putyn/nixie-clock/resources/in4_manual.jpg

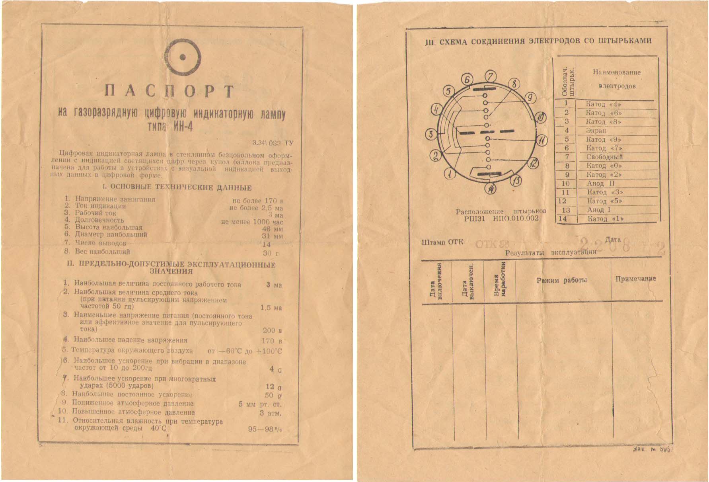
resources/in4_manual.jpg
