putyn/nixie-clock/README.md

naked nixie
=========

IN4 nixie tube + ESP8266
