putyn/nixie-clock/nixie-tubes/README.md

IN4 nixie tube PCB
------

1. in4_single_v0.1
	first version wth single nixie and power supply on the same board, idea was to test the power supplay and the driving circuit for nixies. Never made
2. in4_single_v0.2_revA
	second version which was manufactured at OSHPark, single nixie design made to be daisy chained
3. in4_single_v0.2_revB
	some improvements to version 0.2 (added another GND connection, some warning signs, change anode current limiting resistor to SMD, changed footprint for '595, reorderd schematic)
