putyn/nixie-clock/case/nixie_case_2_back_iso.png

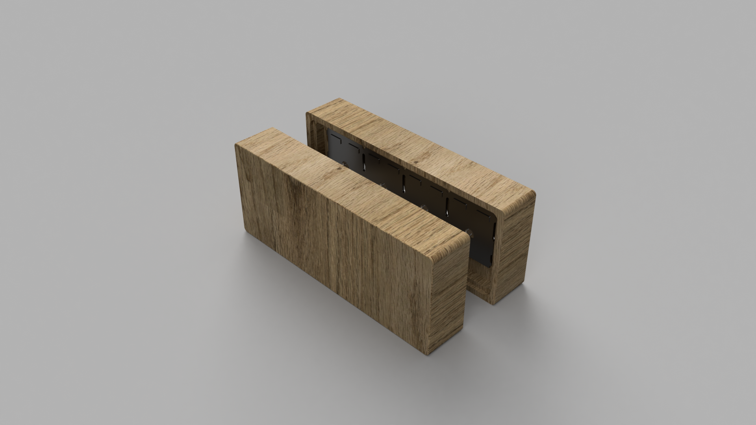
case/nixie_case_2_back_iso.png
