putyn/nixie-clock/case/nixie_case_2_front_iso.png

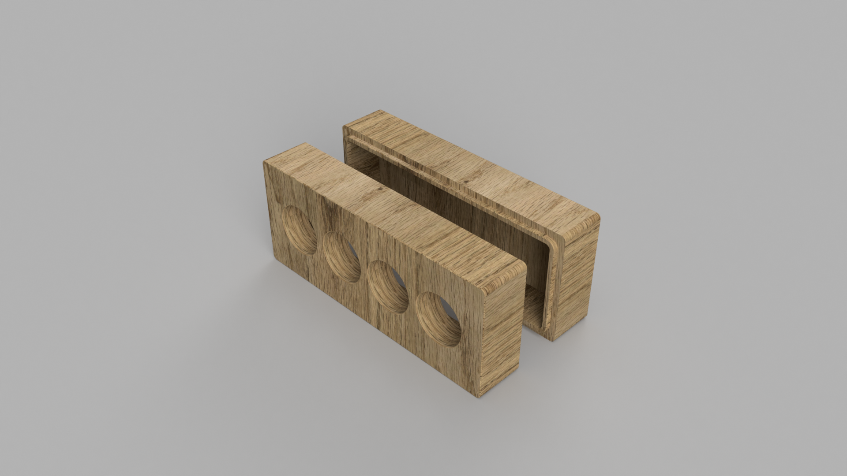
case/nixie_case_2_front_iso.png
