putyn/nixie-clock/case/in4_single_cutout.dxf

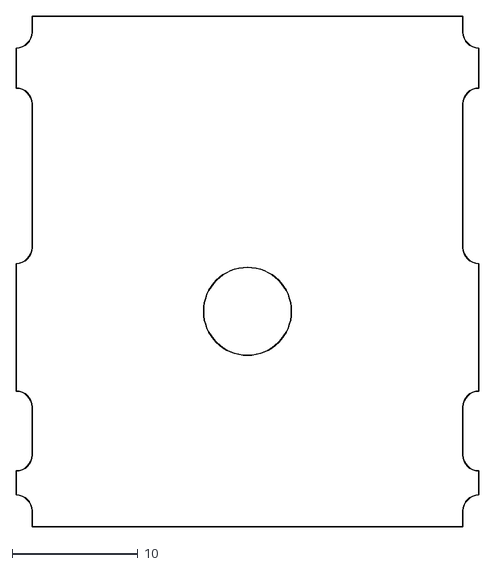
[picture p4: CAD file, 2017-02-05]
case/in4_single_cutout.dxf
36.8 x 40.6
