putyn/nixie-clock/(threads)

Thread 1 (2019-05-06):

Gerber File?

andreacampanella, 2019-05-06:
Would be nice to have gerber files for the PCBs as well :)

fabi280, 2019-05-14:
[in4_control_v1.0_revA_2019-05-06.zip](https://github.com/putyn/nixie-clock/files/3177637/in4_control_v1.0_revA_2019-05-06.zip)
[in4_single_v0.2_revB_2019-05-06.zip](https://github.com/putyn/nixie-clock/files/3177638/in4_single_v0.2_revB_2019-05-06.zip)
[in4_single_v0.2_revA_2019-05-14.zip](https://github.com/putyn/nixie-clock/files/3177644/in4_single_v0.2_revA_2019-05-14.zip)
[boosst_new_2019-05-14.zip](https://github.com/putyn/nixie-clock/files/3177650/boosst_new_2019-05-14.zip)
[boosst_revA_2019-05-14.zip](https://github.com/putyn/nixie-clock/files/3177651/boosst_revA_2019-05-14.zip)
[boosst_revB_2019-05-14.zip](https://github.com/putyn/nixie-clock/files/3177652/boosst_revB_2019-05-14.zip)

Closed 2021-03-08.

Thread 2 (2019-05-06):

BOM

xk4l23, 2019-05-06:
Hi, this is really a great project, would like to build one for me, too. Is there any change to get the BOM to the schematic? Or did I miss it? If so, please point me to the right place.

fabi280, 2019-05-11:
Yeah, you're right. Although you can even create a BOM there aren't any values specified

xk4l23, 2019-05-11:
That is what I am asking about. The values for the parts.

putyn, 2021-03-08:
looks like I'm a lousy repo owner, I don't have notifications turned on. @xk4l23 are you still interested in the BOM?
