putyn/nixie-clock/resources/Nixie Clock Rev C.PDF

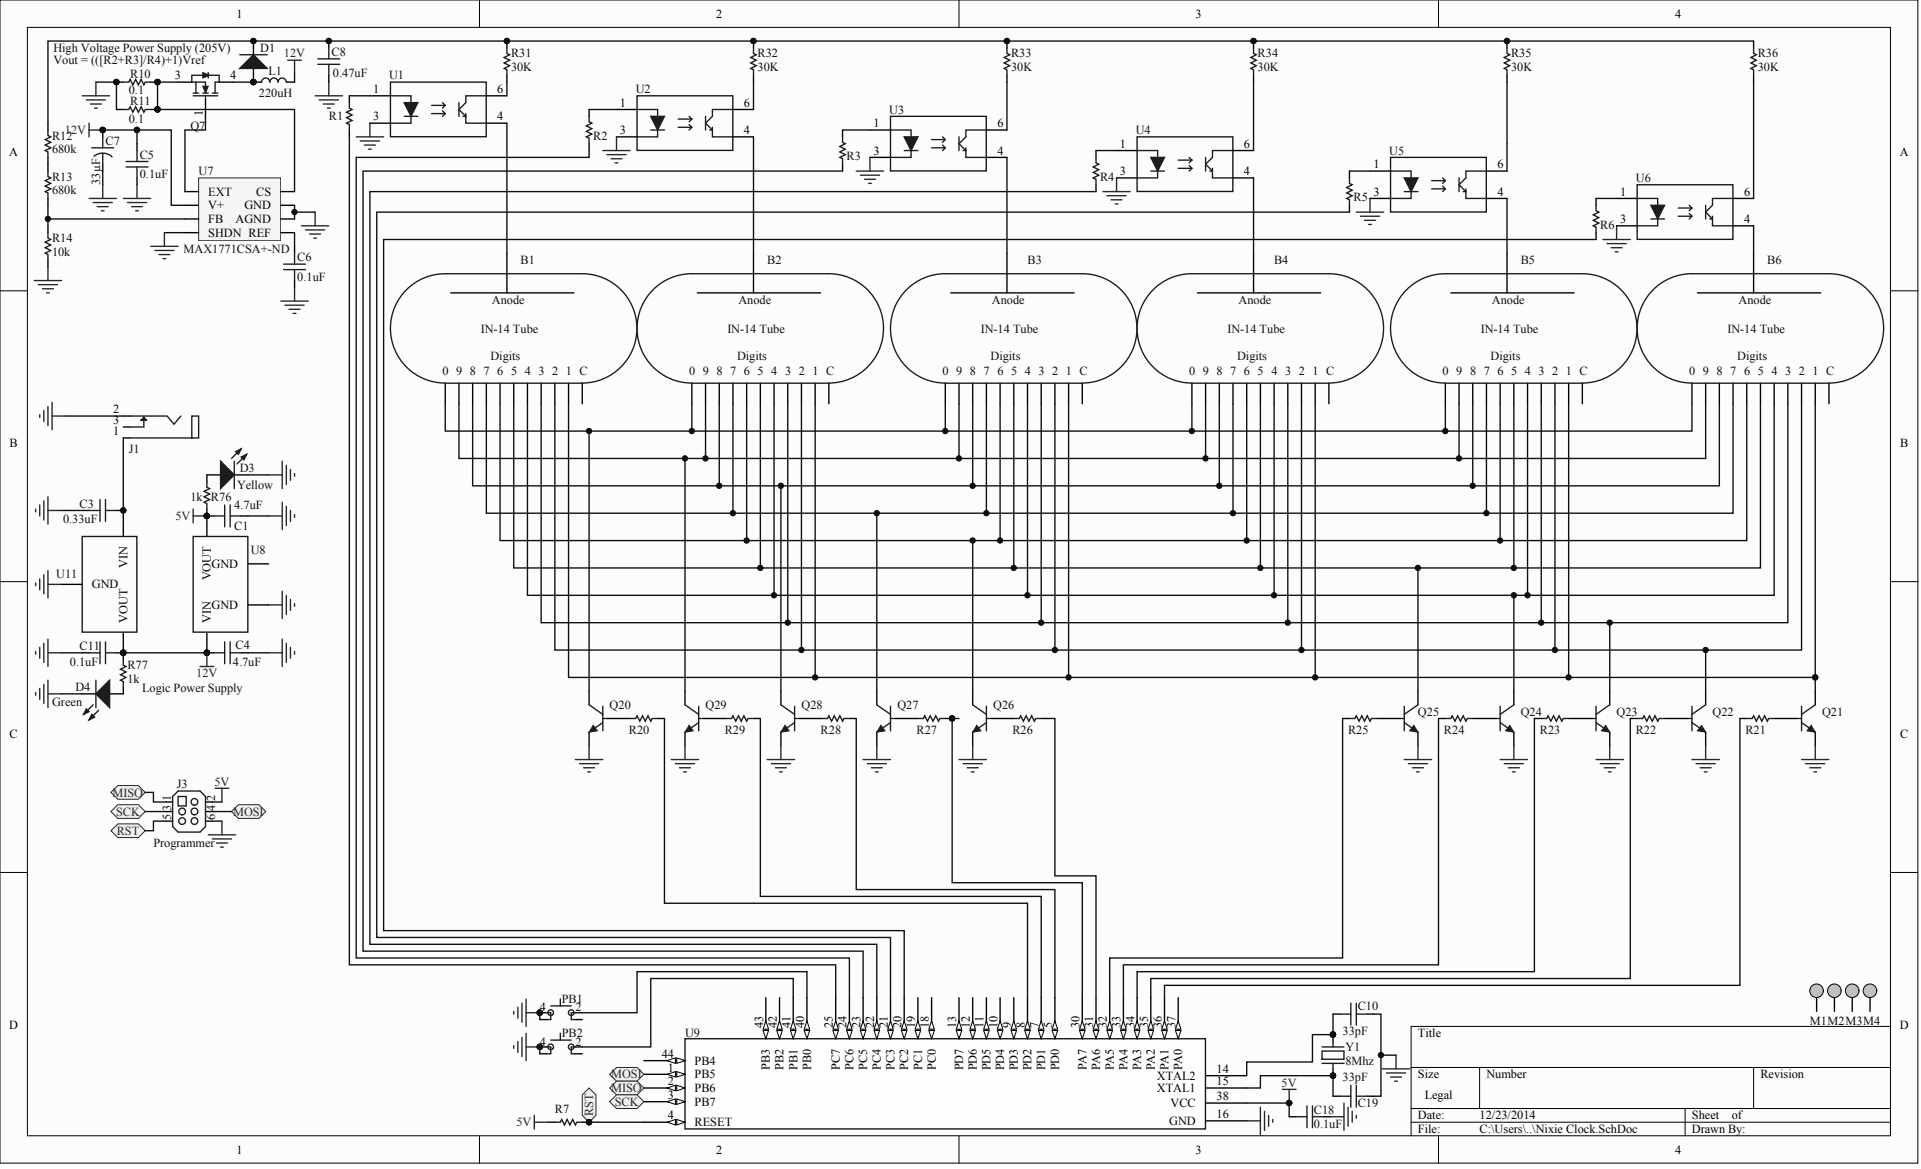
[picture p5: page 1]

V+ GND FB AGND SHDN REF
