putyn/nixie-clock/nixie-tubes/in4_control_v1.0_revA_sch.pdf

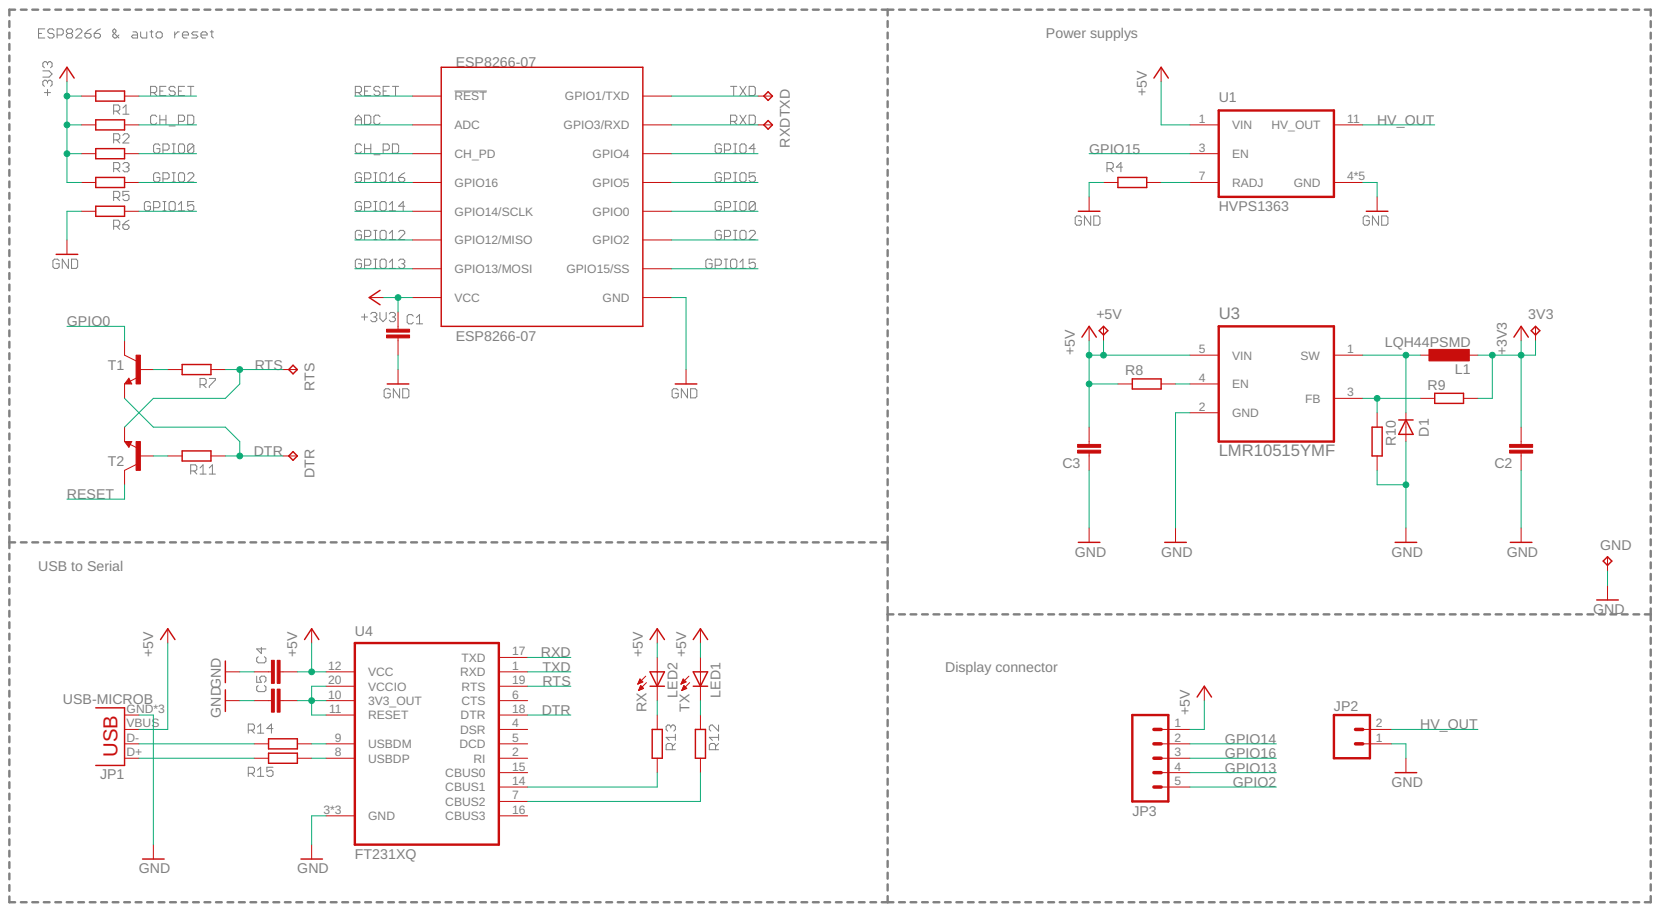
[picture p6: page 1]
