putyn/nixie-clock/nixie-tubes/in4_single_v0.2_revB_sch.pdf

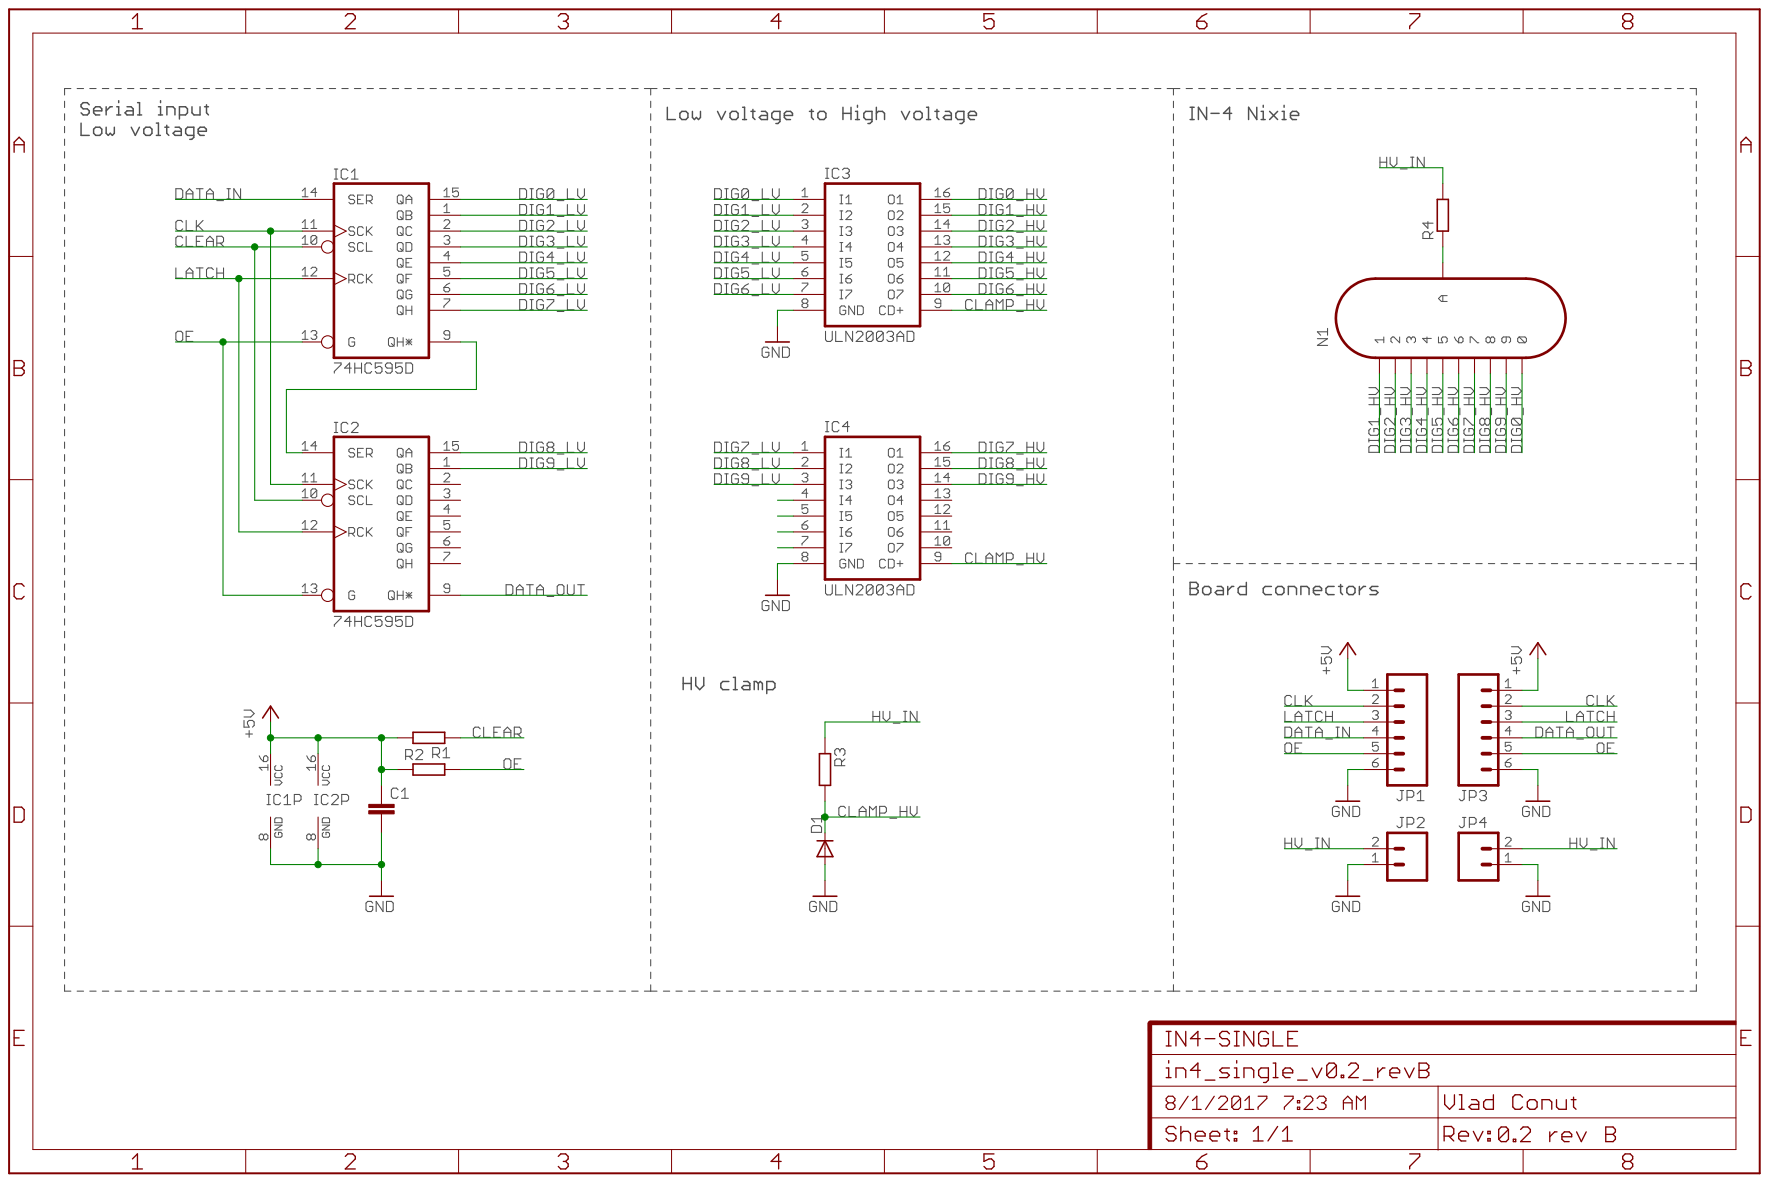
[picture p7: page 1]
