putyn/nixie-clock/resources/flw-schematic.pdf

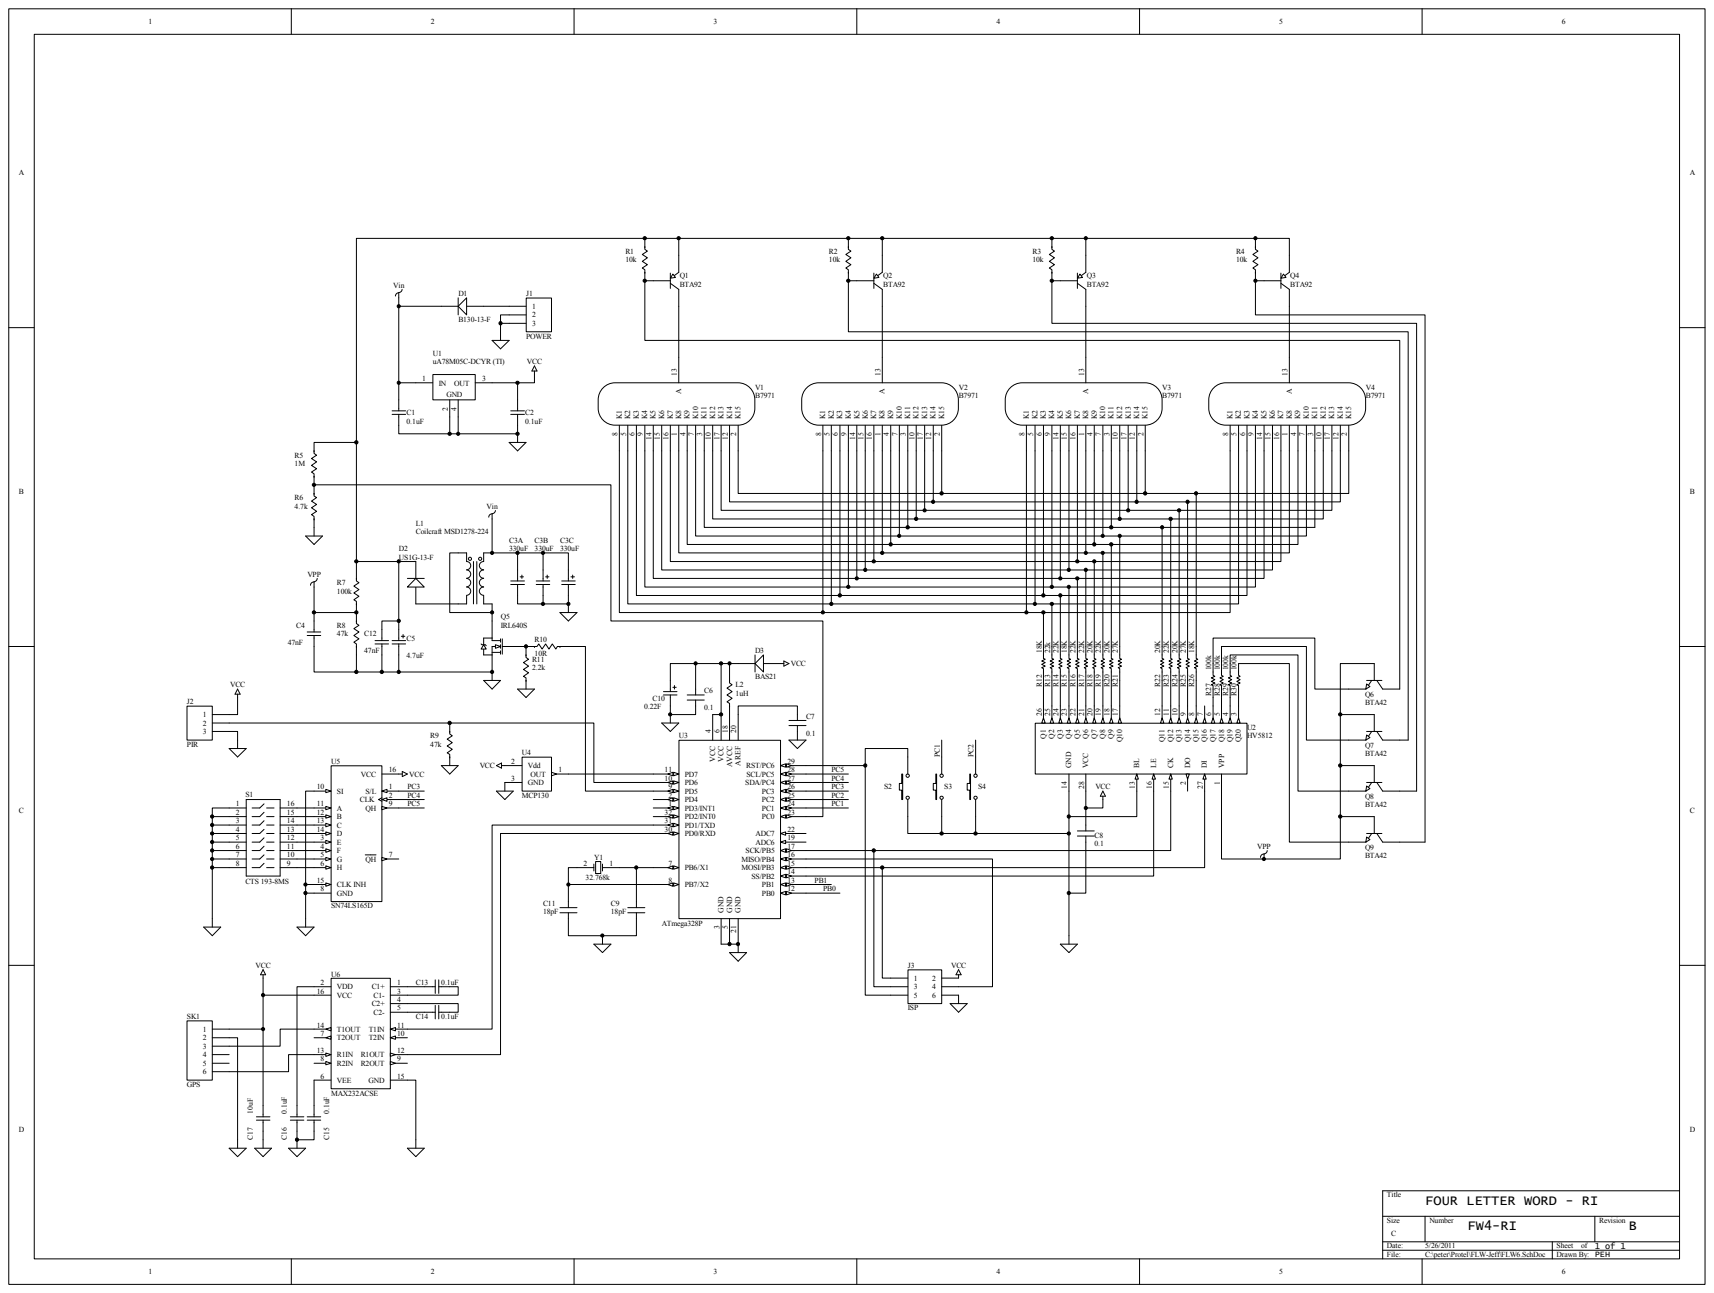
[picture p8: page 1]

FOUR LETTER WORD - RI
