putyn/nixie-clock/nixie-tubes/in4_single_v0.2_revB.brd

## EAGLE design nixie-tubes/in4_single_v0.2_revB.brd (2017-08-01)

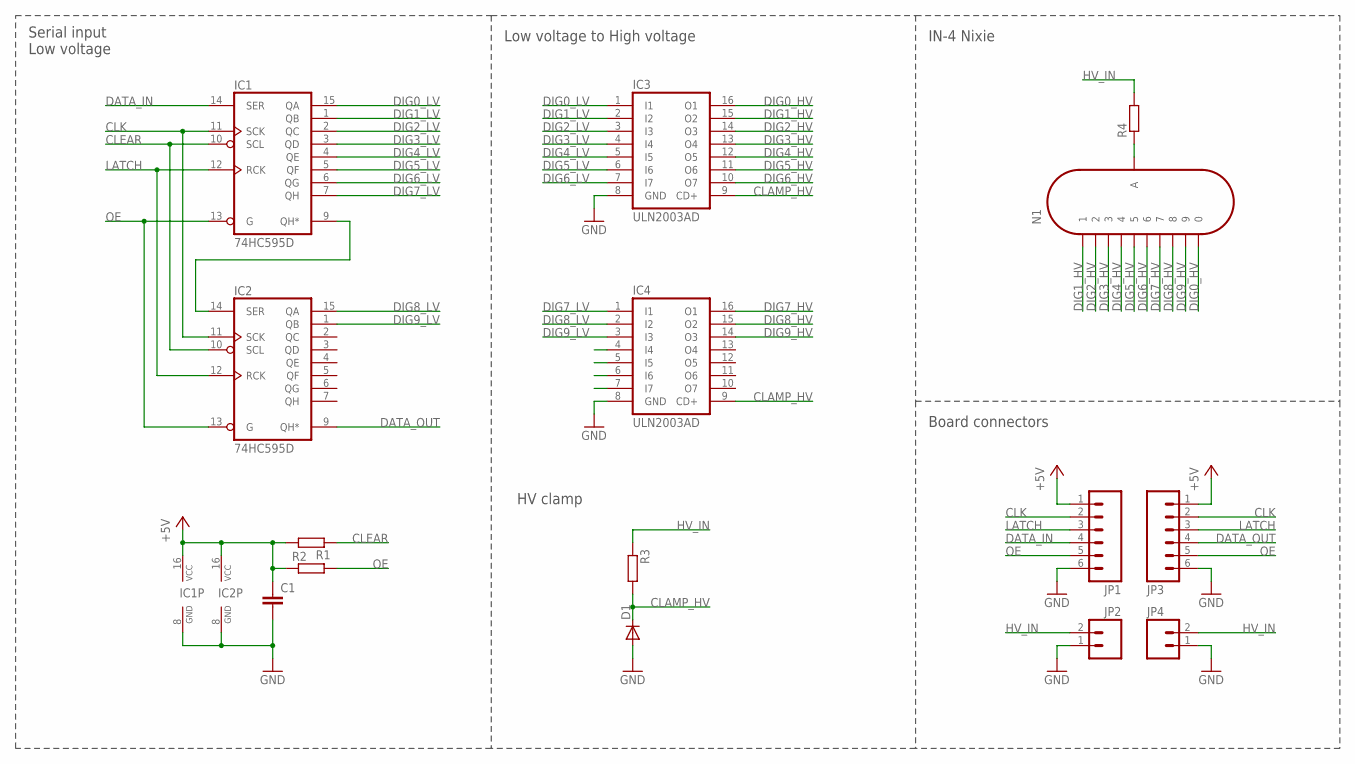
[picture p9: schematic in4_single_v0.2_revB.sch]

Parts:
C1: C-EUC0805; C0805
D1: DIODE-SOD-123; SOD-123
IC1, IC2: 74HC595D; SO16
IC3, IC4: ULN2003AD; SO16
JP1, JP3: M06NO_SILK_FEMALE_PTH; 1X06_NO_SILK
JP2, JP4: M021X02_NO_SILK; 1X02_NO_SILK
N1: IN-4
R1, R2, R3: R-EU_R0805; R0805
R4: R-EU_R1210; R1210

Connections:
+5V: C1.1, IC1.16 (VCC), IC2.16 (VCC), JP1.1, JP3.1, R1.2, R2.1
CLAMP_HV: D1.C, IC3.9 (CD+), IC4.9 (CD+), R3.2
CLEAR: IC1.10 (SCL), IC2.10 (SCL), R1.1
CLK: IC1.11 (SCK), IC2.11 (SCK), JP1.2, JP3.2
DATA_IN: IC1.14 (SER), JP1.4
DATA_OUT: IC2.9 (QH*), JP3.4
DIG0_HV: IC3.16 (O1), N1.8 (0)
DIG0_LV: IC1.15 (QA), IC3.1 (I1)
DIG1_HV: IC3.15 (O2), N1.14 (1)
DIG1_LV: IC1.1 (QB), IC3.2 (I2)
DIG2_HV: IC3.14 (O3), N1.9 (2)
DIG2_LV: IC1.2 (QC), IC3.3 (I3)
DIG3_HV: IC3.13 (O4), N1.11 (3)
DIG3_LV: IC1.3 (QD), IC3.4 (I4)
DIG4_HV: IC3.12 (O5), N1.1 (4)
DIG4_LV: IC1.4 (QE), IC3.5 (I5)
DIG5_HV: IC3.11 (O6), N1.12 (5)
DIG5_LV: IC1.5 (QF), IC3.6 (I6)
DIG6_HV: IC3.10 (O7), N1.2 (6)
DIG6_LV: IC1.6 (QG), IC3.7 (I7)
DIG7_HV: IC4.16 (O1), N1.6 (7)
DIG7_LV: IC1.7 (QH), IC4.1 (I1)
DIG8_HV: IC4.15 (O2), N1.3 (8)
DIG8_LV: IC2.15 (QA), IC4.2 (I2)
DIG9_HV: IC4.14 (O3), N1.5 (9)
DIG9_LV: IC2.1 (QB), IC4.3 (I3)
GND: C1.2, D1.A, IC1.8 (GND), IC2.8 (GND), IC3.8 (GND), IC4.8 (GND), JP1.6, JP2.1, JP3.6, JP4.1
HV_IN: JP2.2, JP4.2, R3.1, R4.2
LATCH: IC1.12 (RCK), IC2.12 (RCK), JP1.3, JP3.3
unnamed: IC1.9 (QH*), IC2.14 (SER)
unnamed: N1.4 (A), R4.1
OE: IC1.13 (G), IC2.13 (G), JP1.5, JP3.5, R2.2

Notes on the sheet:
Serial input Low voltage
Low voltage to High voltage
HV clamp
IN-4 Nixie
Board connectors

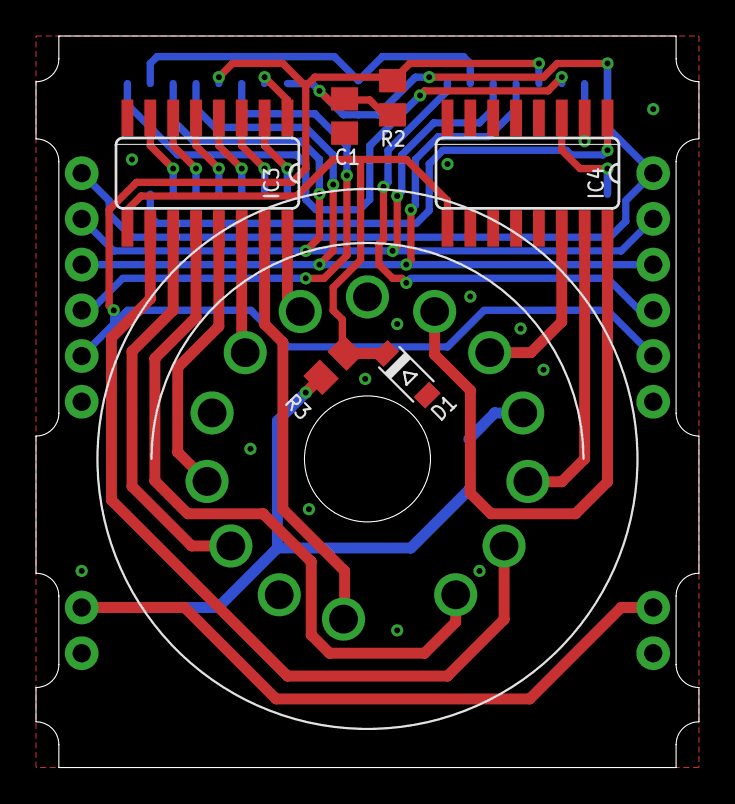
[picture p10: board in4_single_v0.2_revB.brd from above]

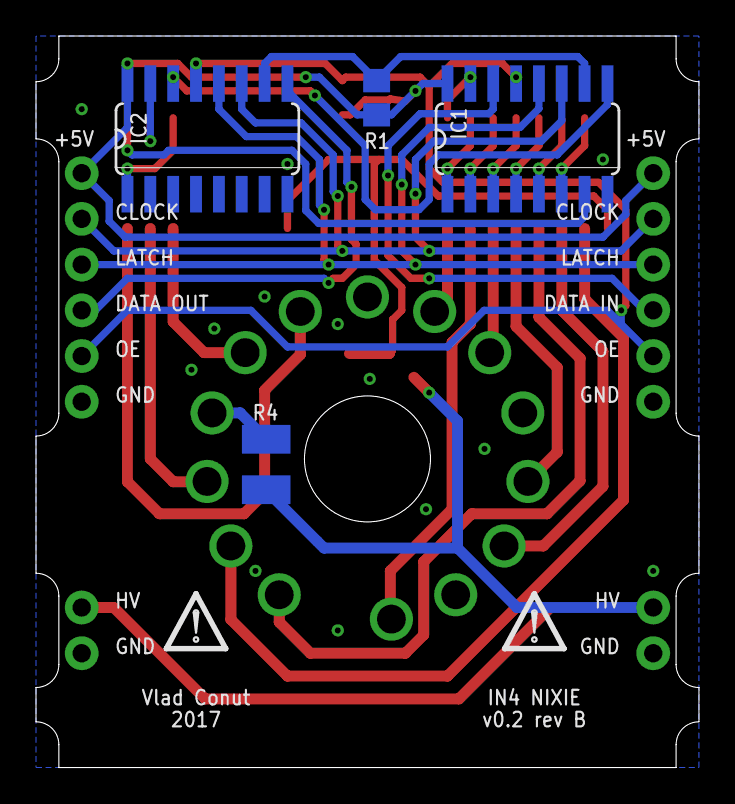
[picture p11: board in4_single_v0.2_revB.brd from below]

Board: 2 copper layers, 36.8 x 40.6 mm, 17 parts (6 on the bottom side), 32 nets.

Other parts of the board:
U$1, U$2: DANGER_LOGO
