putyn/nixie-clock/nixie-tubes/in4_control_v1.0_revA.brd

## EAGLE design nixie-tubes/in4_control_v1.0_revA.brd (2017-03-06)

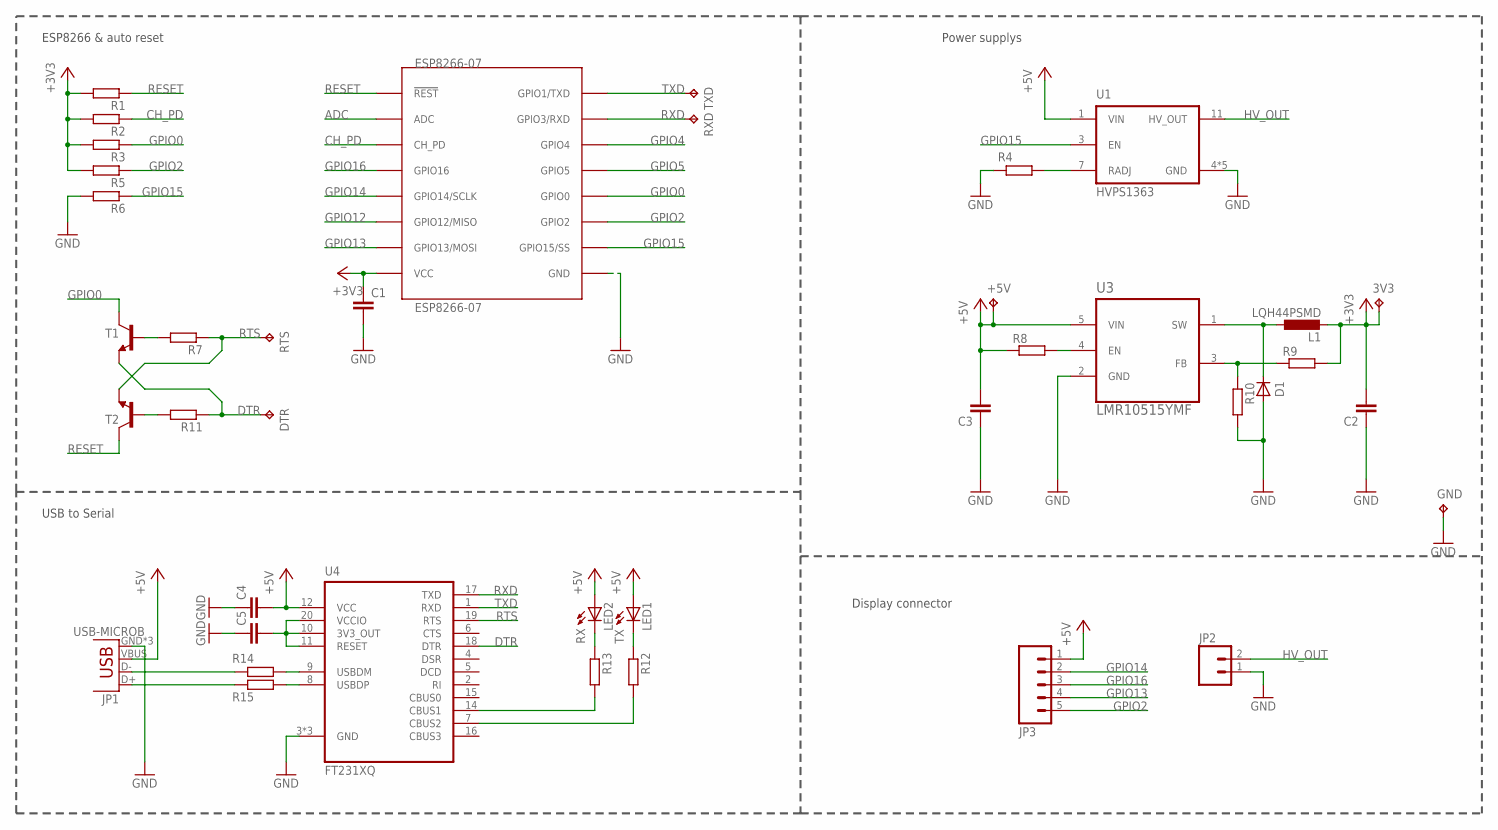
[picture p12: schematic in4_control_v1.0_revA.sch]

Parts:
3V3: TPTP15R; TP15R
+5V: TPTP17R; TP17R
C1, C2, C3: C-EUC0805; C0805
C4, C5: C-EUC0603; C0603
D1: DIODE-SOD-123; SOD-123
DTR: TPTP17R; TP17R
ESP8266-07: ESP8266-07; ESP07
GND: TPTP17R; TP17R
JP1: USB-MICROB
JP2: M021X02_NO_SILK; 1X02_NO_SILK
JP3: M05PTH; 1X05
L1: LQH44PSMD; 1515
LED1: TX; CHIP-LED0603
LED2: RX; CHIP-LED0603
R1, R2, R3, R4, R5, R6, R7, R8, R9, R10, R11, R12, R13, R14, R15: R-EU_R0603; R0603
RTS: TPTP17R; TP17R
RXD: TPTP17R; TP17R
T1, T2: MMBT3904LT1-NPN-SOT23-BEC; SOT23-BEC
TXD: TPTP17R; TP17R
U1: HVPS1363; HVPS-1363
U3: LMR10515YMF; SOT95P290X145-5N
U4: FT231XQ; QFN-20

Connections:
+3V3: 3V3.TP, C1.1, C2.2, ESP8266-07.VCC, L1.2, R1.2, R2.2, R3.2, R5.2, R9.2
+5V: +5V.TP, C3.2, C4.2, JP1.VBUS, JP3.1, LED1.A, LED2.A, R8.1, U1.1 (VIN), U3.5 (VIN), U4.12 (VCC)
ADC: ESP8266-07.ADC
CH_PD: ESP8266-07.CH_PD, R2.1
DTR: DTR.TP, R11.1, T1.E, U4.18 (DTR)
GND: C1.2, C2.1, C3.1, C4.1, C5.1, D1.A, ESP8266-07.GND, GND.TP, JP1.GND, JP1.MT1 (GND), JP1.MT2 (GND), JP2.1, R4.2, R6.2, R10.2, U1.4 (GND), U1.6 (GND), U1.8 (GND), U1.9 (GND), U1.10 (GND), U3.2 (GND), U4.3 (GND), U4.13 (GND), U4.21 (GND)
GPIO0: ESP8266-07.GPIO0, R3.1, T1.C
GPIO2: ESP8266-07.GPIO2, JP3.5, R5.1
GPIO4: ESP8266-07.GPIO4
GPIO5: ESP8266-07.GPIO5
GPIO12: ESP8266-07.GPIO12 (GPIO12/MISO)
GPIO13: ESP8266-07.GPIO13 (GPIO13/MOSI), JP3.4
GPIO14: ESP8266-07.GPIO14 (GPIO14/SCLK), JP3.2
GPIO15: ESP8266-07.GPIO15 (GPIO15/SS), R6.1, U1.3 (EN)
GPIO16: ESP8266-07.GPIO16, JP3.3
HV_OUT: JP2.2, U1.11 (HV_OUT)
unnamed: C5.2, U4.10 (3V3_OUT), U4.11 (RESET), U4.20 (VCCIO)
unnamed: R8.2, U3.4 (EN)
unnamed: R9.1, R10.1, U3.3 (FB)
unnamed: R14.1, U4.9 (USBDM)
unnamed: R15.1, U4.8 (USBDP)
unnamed: JP1.D+, R15.2
unnamed: JP1.D-, R14.2
unnamed: LED2.C, R13.1
unnamed: LED1.C, R12.1
unnamed: R13.2, U4.14 (CBUS1)
unnamed: R12.2, U4.7 (CBUS2)
unnamed: R4.1, U1.7 (RADJ)
unnamed: R11.2, T2.B
unnamed: R7.2, T1.B
RESET: ESP8266-07.REST (!REST!), R1.1, T2.C
RTS: R7.1, RTS.TP, T2.E, U4.19 (RTS)
RXD: ESP8266-07.RXD (GPIO3/RXD), RXD.TP, U4.17 (TXD)
SW: D1.C, L1.1, U3.1 (SW)
TXD: ESP8266-07.TXD (GPIO1/TXD), TXD.TP, U4.1 (RXD)

Notes on the sheet:
ESP8266 & auto reset
Display connector
USB to Serial
Power supplys

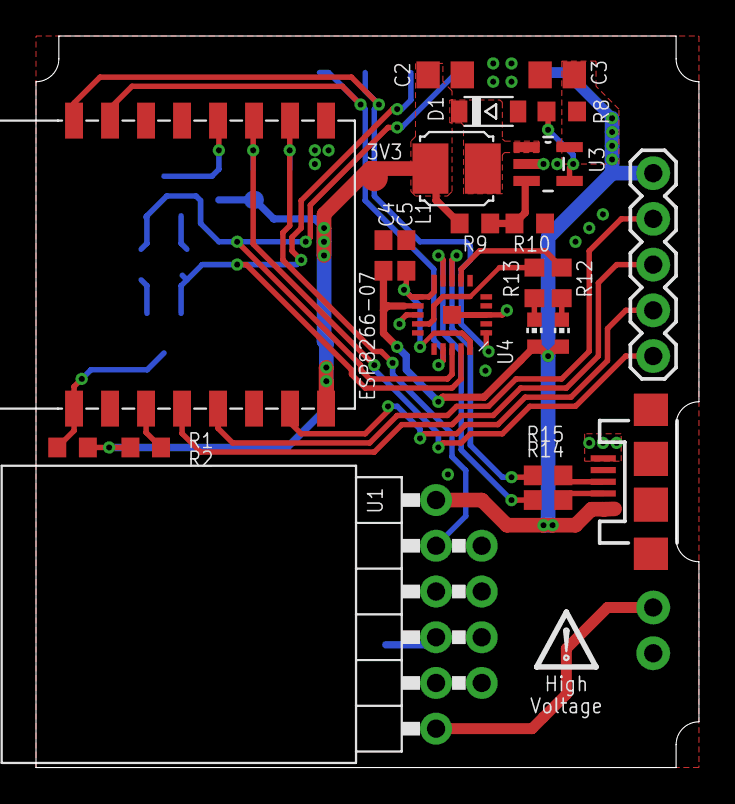
[picture p13: board in4_control_v1.0_revA.brd from above]

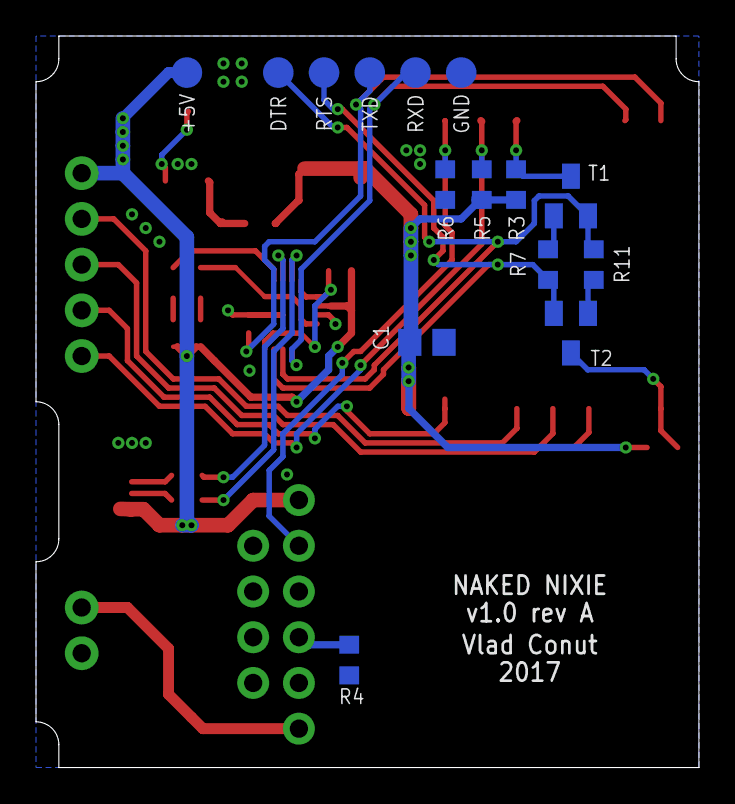
[picture p14: board in4_control_v1.0_revA.brd from below]

Board: 2 copper layers, 36.8 x 40.6 mm, 41 parts (15 on the bottom side), 31 nets.

Other parts of the board:
U$1: DANGER_LOGO
