putyn/nixie-clock/power-supply/boosst_revB.brd

## EAGLE design power-supply/boosst_revB.brd (2017-02-05)

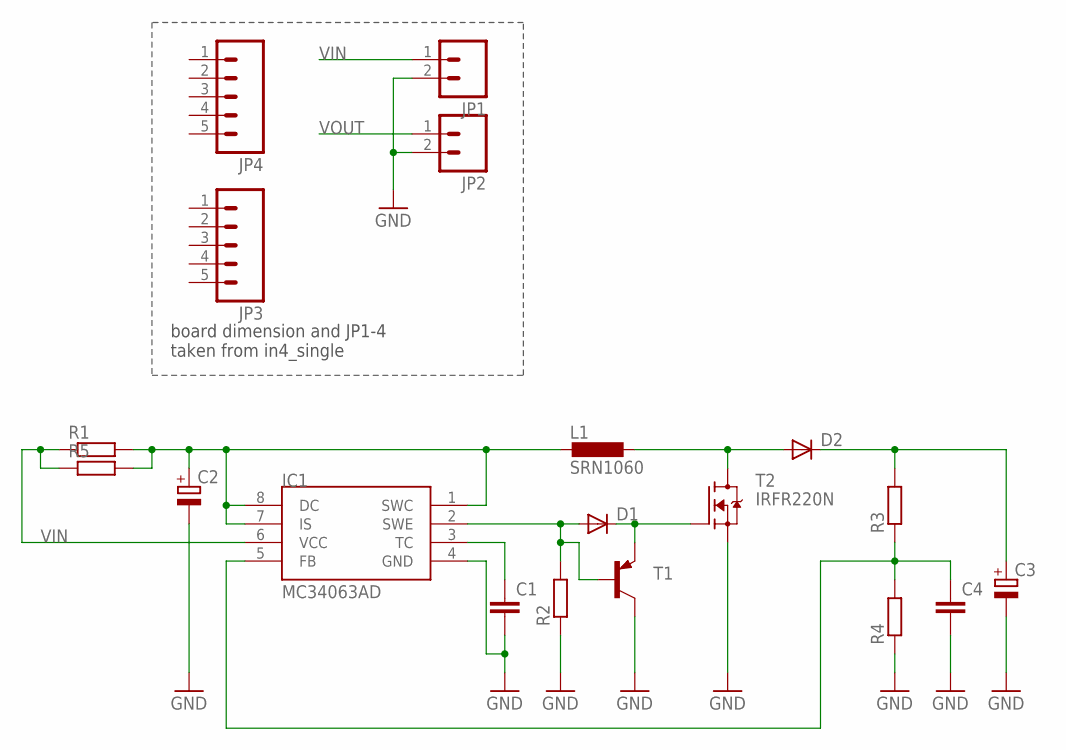
[picture p15: schematic boosst_revB.sch]

Parts:
C1, C4: C-EUC1206; C1206
C2: CPOL-EUE2.5-6; E2,5-6
C3: CPOL-EUE2,5-6E; E2,5-6E
D1: DIODE-SOD123; SOD123
D2: DIODE-SMB; SMB
IC1: MC34063AD; SOIC8
JP1, JP2: M02PTH; 1X02
JP3, JP4: M05PTH; 1X05
L1: SRN1060
R1, R5: R-EU_M1206; M1206
R2, R3, R4: R-EU_R1206; R1206
T1: MMBT3906LT1-PNP-SOT23-BEC; SOT23-BEC
T2: IRFR220N; DPACK

Connections:
GND: C1.2, C2.-, C3.-, C4.2, IC1.4 (GND), JP1.2, JP2.2, R2.1, R4.1, T1.C, T2.3 (S)
unnamed: D1.C, T1.E, T2.1 (G)
unnamed: D1.A, IC1.2 (SWE), R2.2, T1.B
unnamed: C1.1, IC1.3 (TC)
unnamed: C4.1, IC1.5 (FB), R3.1, R4.2
unnamed: C2.+, IC1.1 (SWC), IC1.7 (IS), IC1.8 (DC), L1.P$2 (2), R1.2, R5.2
SW: D2.A, L1.P$1 (1), T2.4 (D)
VIN: IC1.6 (VCC), JP1.1, R1.1, R5.1
VOUT: C3.+, D2.C, JP2.1, R3.2

Notes on the sheet:
board dimension and JP1-4 taken from in4_single

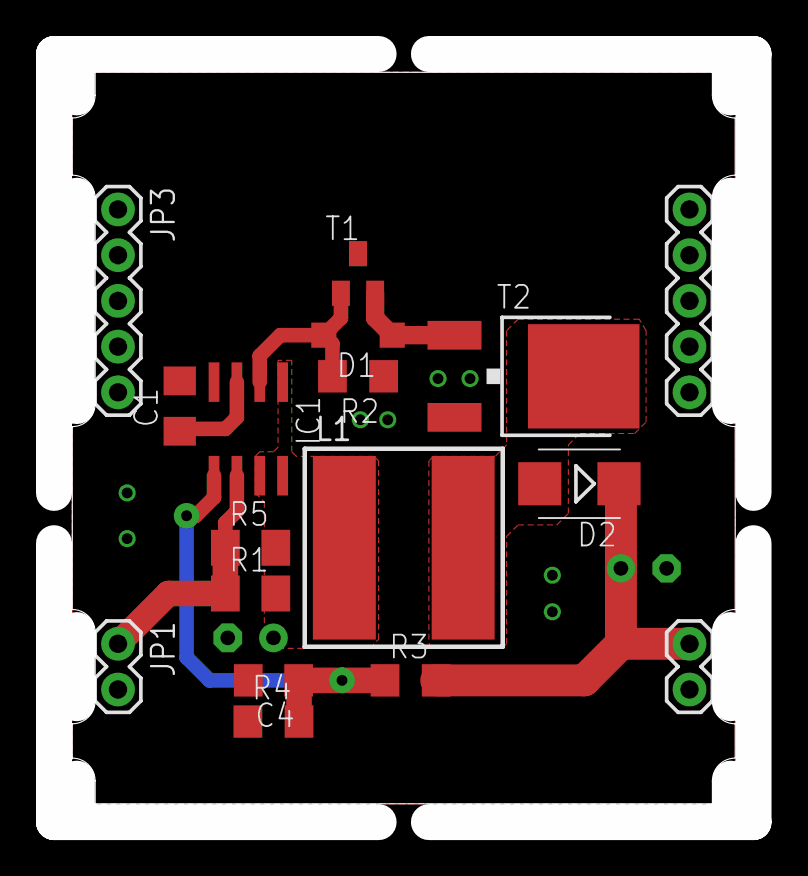
[picture p16: board boosst_revB.brd from above]

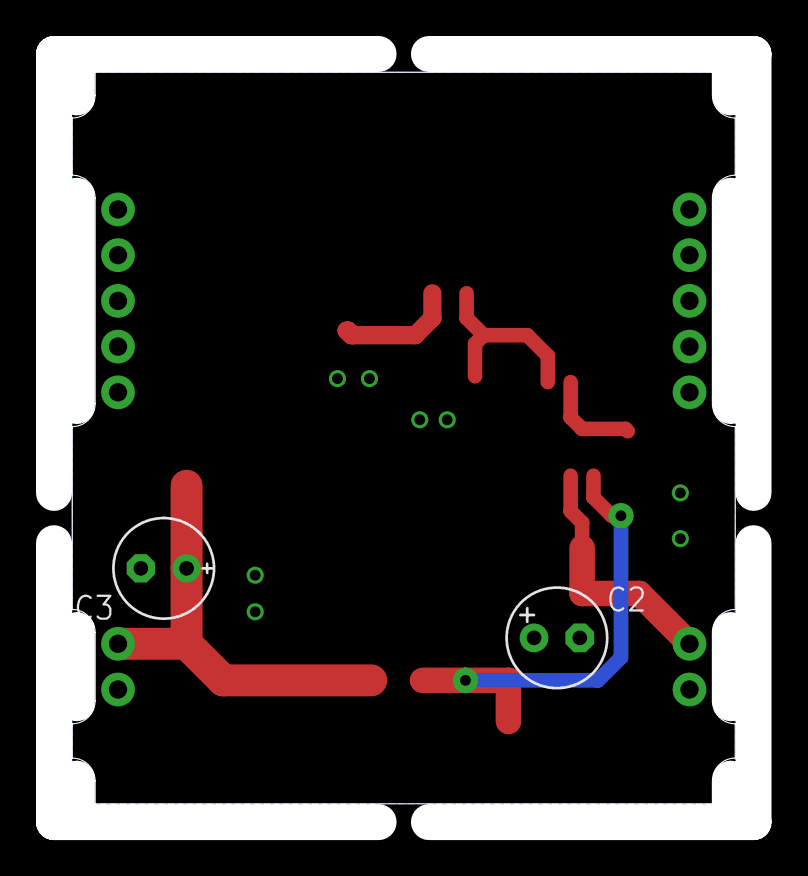
[picture p17: board boosst_revB.brd from below]

Board: 2 copper layers, 38.9 x 42.7 mm, 19 parts (2 on the bottom side), 9 nets.
