putyn/nixie-clock/power-supply/boosst_revA.brd

## EAGLE design power-supply/boosst_revA.brd (2017-01-12, an earlier design)

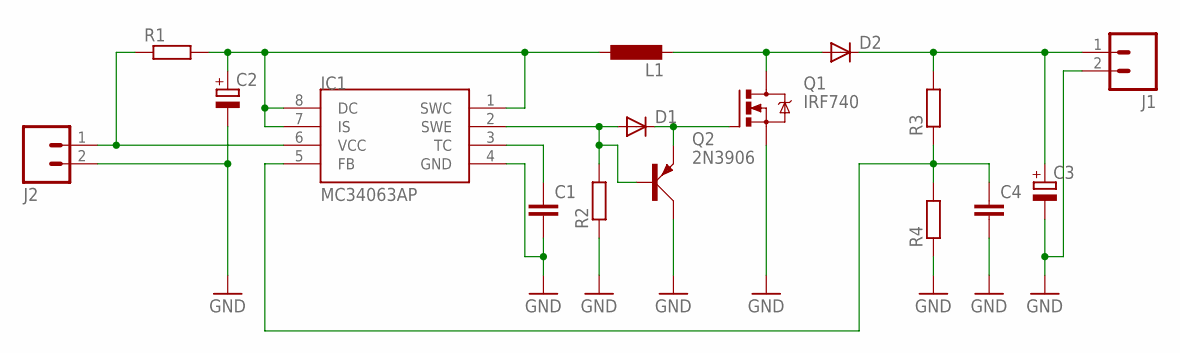
[picture p18: schematic boosst_revA.sch]

Parts:
C1, C4: C-EU025-025X050; C025-025X050
C2, C3: CPOL-EUE5-8.5; E5-8,5
D1: DIODE-D-5; D-5
D2: DIODE-DO41-7.6; DO41-7.6
IC1: MC34063AP; DIL08
J1, J2: M023.5MM; SCREWTERMINAL-3.5MM-2
L1: L-EU6000-XXX-RC; 6000-XXXX-RC
Q1: IRF740; TO220BV
Q2: 2N3906; TO92D
R1: R-EU_0309/10; 0309/10
R2: R-EU_0204/5; 0204/5
R3, R4: R-EU_0204/7; 0204/7

Connections:
GND: C1.2, C2.-, C3.-, C4.2, IC1.4 (GND), J1.2, J2.2, Q1.S, Q2.C, R2.1, R4.1
unnamed: C3.+, D2.C, J1.1, R3.2
unnamed: D1.C, Q1.G, Q2.E
unnamed: D1.A, IC1.2 (SWE), Q2.B, R2.2
unnamed: C1.1, IC1.3 (TC)
unnamed: C4.1, IC1.5 (FB), R3.1, R4.2
unnamed: C2.+, IC1.1 (SWC), IC1.7 (IS), IC1.8 (DC), L1.1, R1.2
unnamed: D2.A, L1.2, Q1.D
VIN: IC1.6 (VCC), J2.1, R1.1

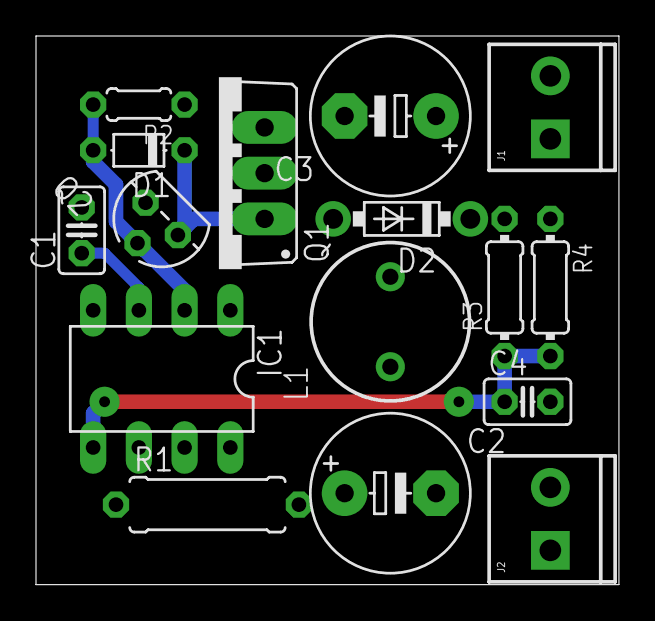
[picture p19: board boosst_revA.brd from above]

Board: 2 copper layers, 32.4 x 30.5 mm, 16 parts (0 on the bottom side), 9 nets.
