putyn/nixie-clock/nixie-tubes/in4_single_v0.1.brd

## EAGLE design nixie-tubes/in4_single_v0.1.brd (2017-01-12, an earlier design)

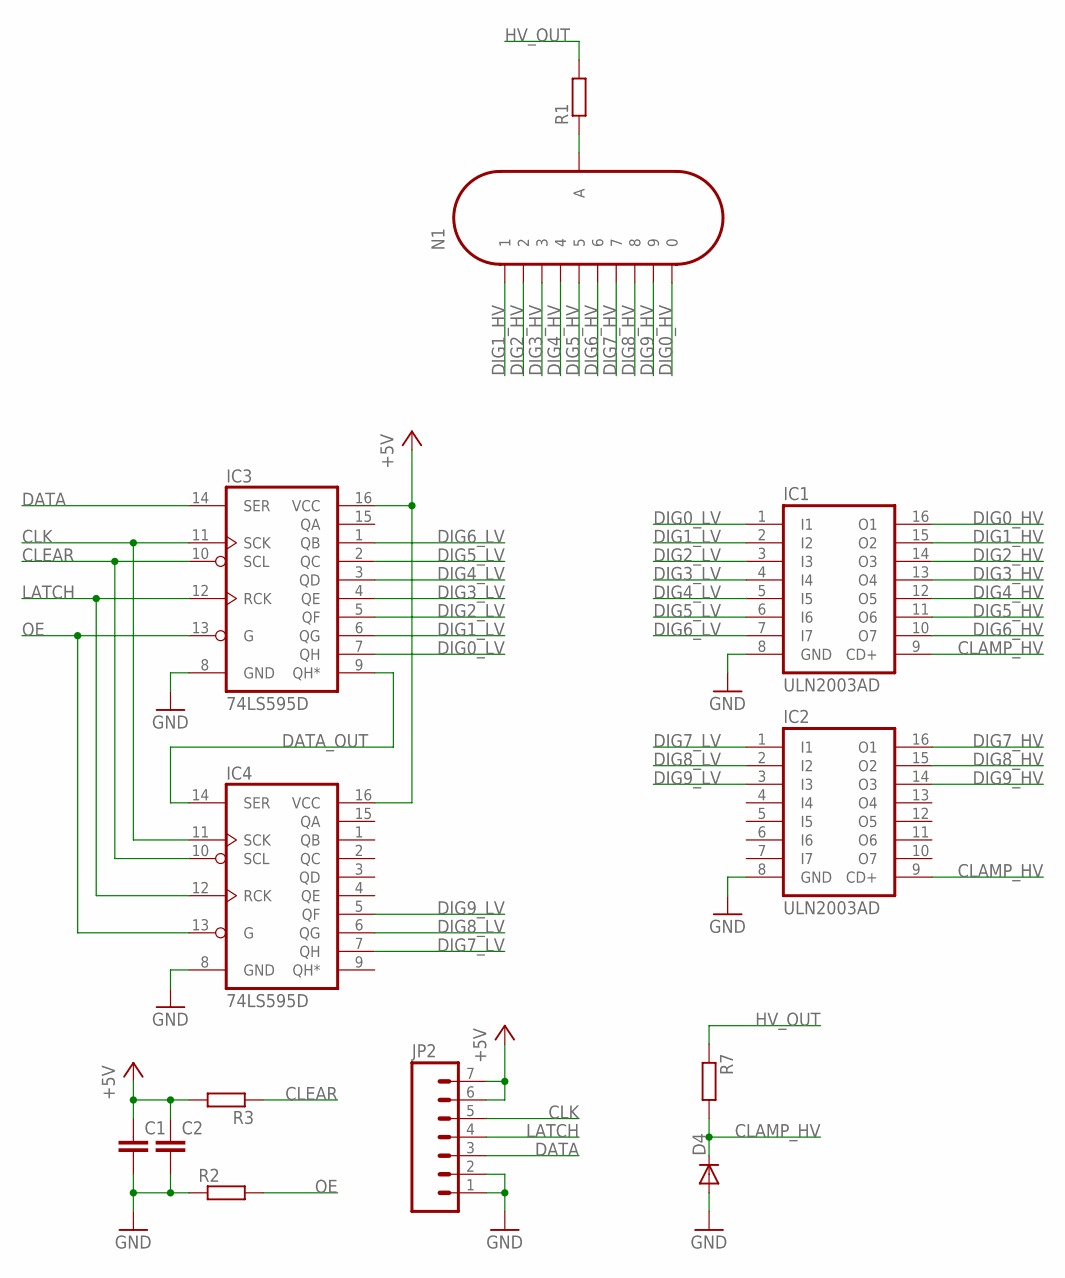
[picture p20: schematic in4_single_v0.1.sch, sheet 1]

Parts:
C1, C2: C-EUC0805; C0805
D4: DIODE-SOD-123; SOD-123
IC1, IC2: ULN2003AD; SO16
IC3, IC4: 74LS595D; SO16
JP2: M07LOCK; 1X07_LOCK
N1: IN-4
R1: R-EU_0204/7; 0204/7
R2, R3, R7: R-EU_R0805; R0805

Connections:
+5V: C1.1, C2.1, IC3.16 (VCC), IC4.16 (VCC), JP2.6, JP2.7, R3.2; also elsewhere on the board
CLAMP_HV: D4.C, IC1.9 (CD+), IC2.9 (CD+), R7.2
CLEAR: IC3.10 (SCL), IC4.10 (SCL), R3.1
CLK: IC3.11 (SCK), IC4.11 (SCK), JP2.5
DATA: IC3.14 (SER), JP2.3
DATA_OUT: IC3.9 (QH*), IC4.14 (SER)
DIG0_HV: IC1.16 (O1), N1.8 (0)
DIG0_LV: IC1.1 (I1), IC3.7 (QH)
DIG1_HV: IC1.15 (O2), N1.14 (1)
DIG1_LV: IC1.2 (I2), IC3.6 (QG)
DIG2_HV: IC1.14 (O3), N1.9 (2)
DIG2_LV: IC1.3 (I3), IC3.5 (QF)
DIG3_HV: IC1.13 (O4), N1.11 (3)
DIG3_LV: IC1.4 (I4), IC3.4 (QE)
DIG4_HV: IC1.12 (O5), N1.1 (4)
DIG4_LV: IC1.5 (I5), IC3.3 (QD)
DIG5_HV: IC1.11 (O6), N1.12 (5)
DIG5_LV: IC1.6 (I6), IC3.2 (QC)
DIG6_HV: IC1.10 (O7), N1.2 (6)
DIG6_LV: IC1.7 (I7), IC3.1 (QB)
DIG7_HV: IC2.16 (O1), N1.6 (7)
DIG7_LV: IC2.1 (I1), IC4.7 (QH)
DIG8_HV: IC2.15 (O2), N1.3 (8)
DIG8_LV: IC2.2 (I2), IC4.6 (QG)
DIG9_HV: IC2.14 (O3), N1.5 (9)
DIG9_LV: IC2.3 (I3), IC4.5 (QF)
GND: C1.2, C2.2, D4.A, IC1.8 (GND), IC2.8 (GND), IC3.8 (GND), IC4.8 (GND), JP2.1, JP2.2, R2.1; also elsewhere on the board
HV_OUT: R1.2, R7.1; also elsewhere on the board
LATCH: IC3.12 (RCK), IC4.12 (RCK), JP2.4
unnamed: N1.4 (A), R1.1
OE: IC3.13 (G), IC4.13 (G), R2.2

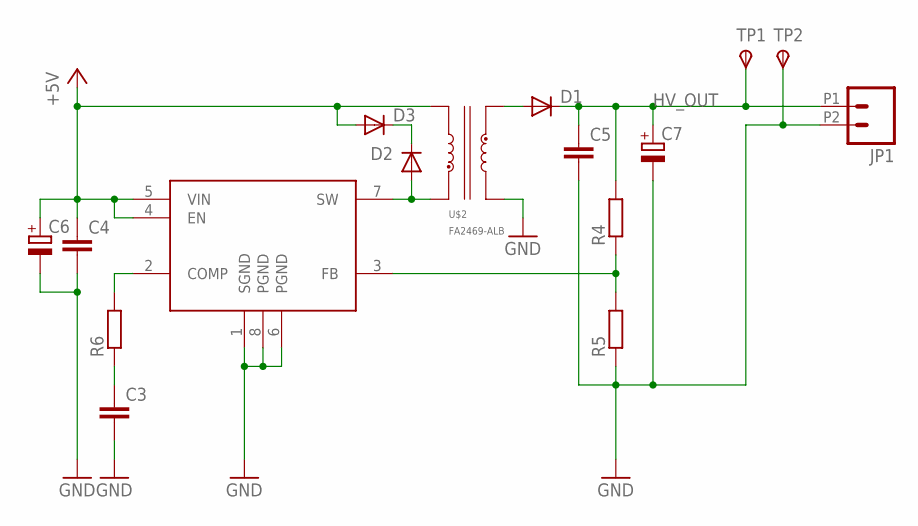
[picture p21: schematic in4_single_v0.1.sch, sheet 2]

Parts:
C3: C-EUC0805; C0805
C4, C5: C-EUC1210; C1210
C6, C7: CPOL-EUE2.5-5; E2,5-5
D1: DIODE-DO-214AC; DO-214AC
D2, D3: DIODE-SOD-123; SOD-123
IC5: MC3172YM; SOIC8
JP1: M022.54MM_SCREWTERM; 1X02_2.54_SCREWTERM
R4, R5, R6: R-EU_R0805; R0805
TP1, TP2: TPSPAD1-13; P1-13
U$2: FA2469-ALB; FA2469

Connections:
+5V: C4.1, C6.+, D3.A, IC5.4 (EN), IC5.5 (VIN), U$2.3; also elsewhere on the board
GND: C3.2, C4.2, C5.2, C6.-, C7.-, IC5.1 (SGND), IC5.6 (PGND), IC5.8 (PGND), JP1.P2 (2), R5.1, TP2.TP, U$2.6; also elsewhere on the board
HV_OUT: C5.1, C7.+, D1.1 (C), JP1.P1 (1), R4.2, TP1.TP; also elsewhere on the board
unnamed: D2.C, D3.C
unnamed: D1.2 (A), U$2.4
unnamed: IC5.2 (COMP), R6.2
unnamed: IC5.3 (FB), R4.1, R5.2
unnamed: C3.1, R6.1
SW: D2.A, IC5.7 (SW), U$2.1

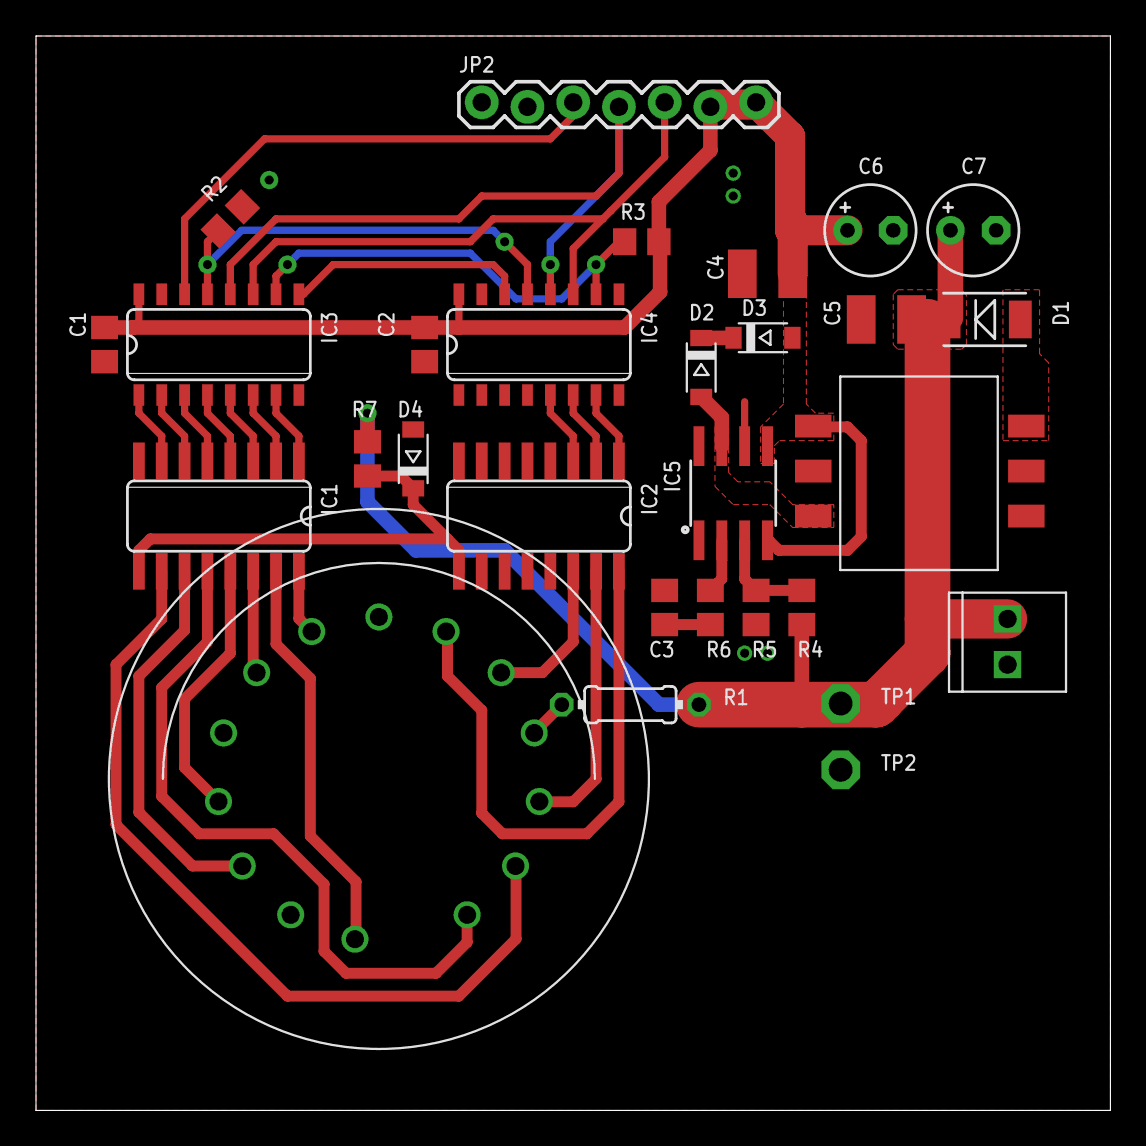
[picture p22: board in4_single_v0.1.brd from above]

Board: 2 copper layers, 59.7 x 59.7 mm, 29 parts (0 on the bottom side), 37 nets.
