putyn/nixie-clock/power-supply/boosst_new.brd

## EAGLE design power-supply/boosst_new.brd (2017-01-12)

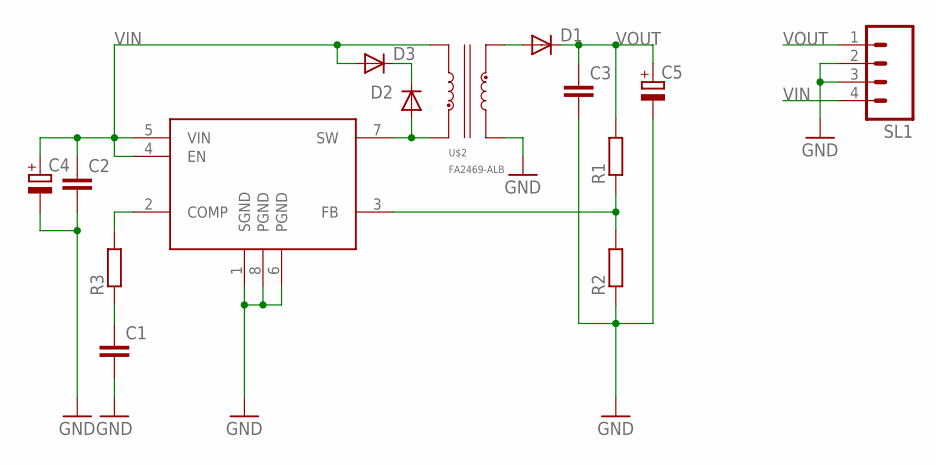
[picture p23: schematic boosst_new.sch]

Parts:
C1: C-EUC0805; C0805
C2, C3: C-EUC1210; C1210
C4, C5: CPOL-EUE2.5-5; E2,5-5
D1: DIODE-DO-214AC; DO-214AC
D2, D3: DIODE-SOD-123; SOD-123
R1, R2, R3: R-EU_R0805; R0805
SL1: M04; 04P
U$1: MC3172YM; SOIC8
U$2: FA2469-ALB; FA2469

Connections:
GND: C1.2, C2.2, C3.2, C4.-, C5.-, R2.1, SL1.2, SL1.3, U$1.1 (SGND), U$1.6 (PGND), U$1.8 (PGND), U$2.6
unnamed: D2.C, D3.C
unnamed: D1.2 (A), U$2.4
unnamed: R3.2, U$1.2 (COMP)
unnamed: R1.1, R2.2, U$1.3 (FB)
unnamed: C1.1, R3.1
SW: D2.A, U$1.7 (SW), U$2.1
VIN: C2.1, C4.+, D3.A, SL1.4, U$1.4 (EN), U$1.5 (VIN), U$2.3
VOUT: C3.1, C5.+, D1.1 (C), R1.2, SL1.1

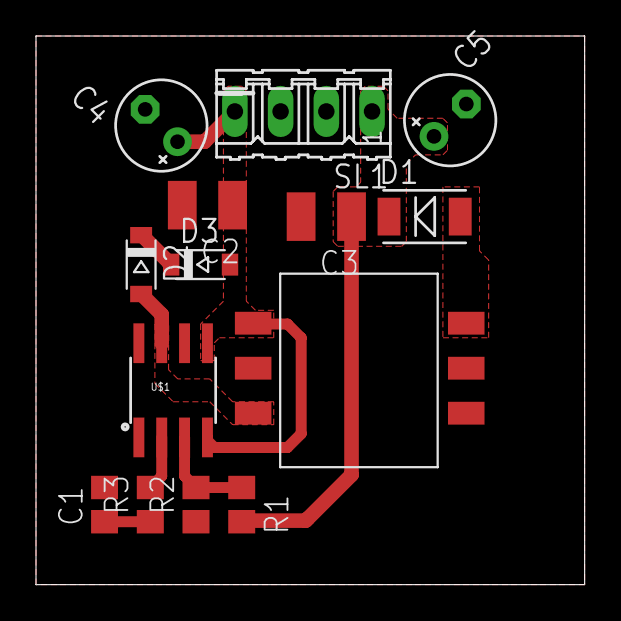
[picture p24: board boosst_new.brd from above]

Board: 2 copper layers, 30.5 x 30.5 mm, 14 parts (0 on the bottom side), 9 nets.
