putyn/nixie-clock/case/in4_mount.brd

## EAGLE design case/in4_mount.brd (2017-01-12)

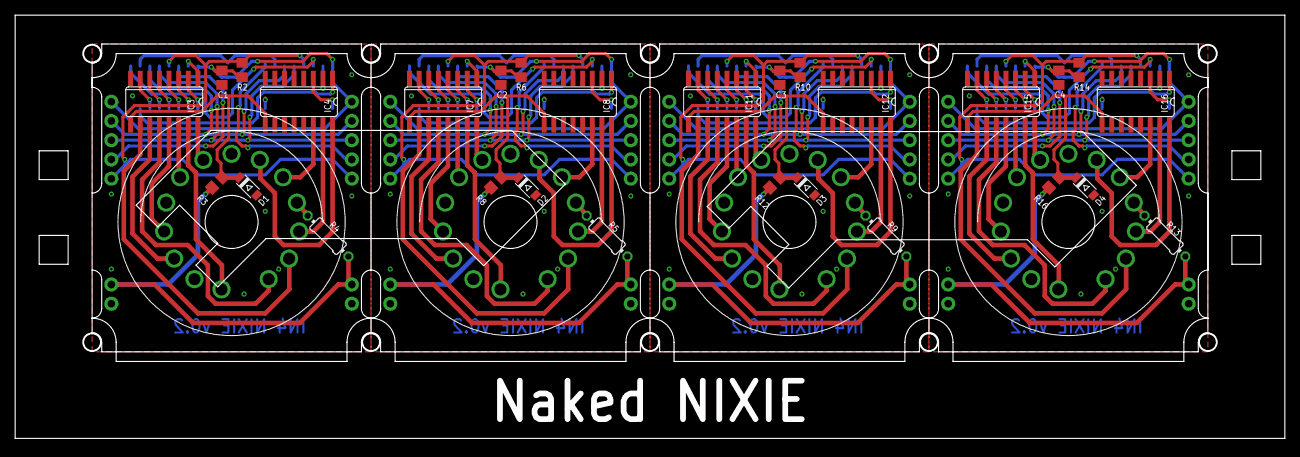
[picture p25: board in4_mount.brd from above]

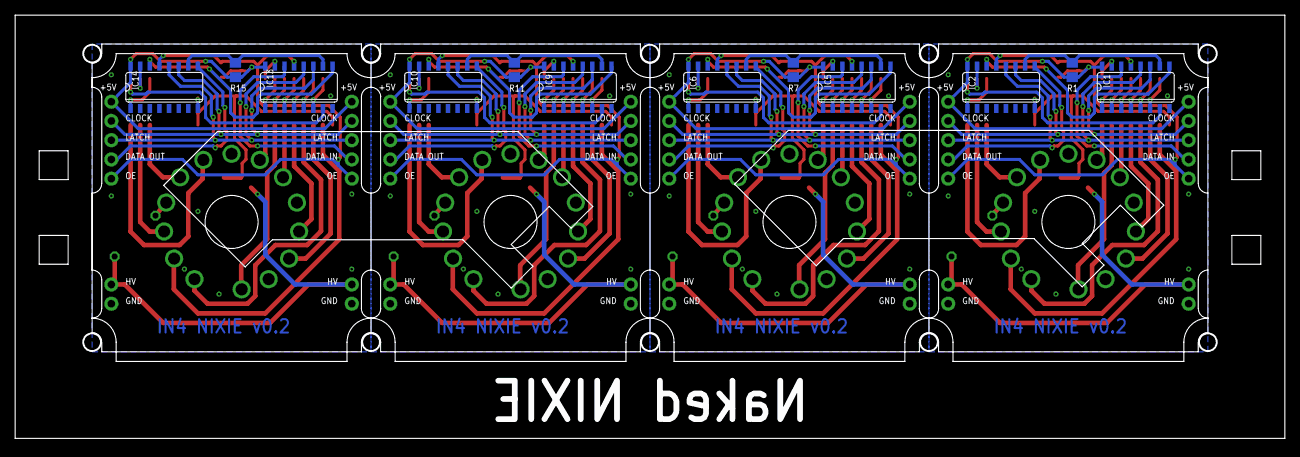
[picture p26: board in4_mount.brd from below]

Board: 2 copper layers, 167.6 x 55.9 mm, 60 parts (12 on the bottom side), 128 nets.

Parts:
C1, C2, C3, C4: C0805
D1, D2, D3, D4: SOD-123
IC1, IC2, IC5, IC6, IC9, IC10, IC13, IC14: 74HC595D; SO16
IC3, IC4, IC7, IC8, IC11, IC12, IC15, IC16: ULN2003AD; SO16
JP1, JP3, JP5, JP6, JP9, JP10, JP13, JP14: 1X05_NO_SILK
JP2, JP4, JP7, JP8, JP11, JP12, JP15, JP16: 1X02_NO_SILK
N1, N2, N3, N4: IN-4
R1, R2, R3, R6, R7, R8, R10, R11, R12, R14, R15, R16: R0805
R4, R5, R9, R13: 0204/7

Connections:
+5V: C1.1, IC1.16, IC2.16, JP1.1, JP3.1, R1.2, R2.1
+5V1: C2.1, IC5.16, IC6.16, JP5.1, JP6.1, R6.1, R7.2
+5V2: C3.1, IC9.16, IC10.16, JP9.1, JP10.1, R10.1, R11.2
+5V3: C4.1, IC13.16, IC14.16, JP13.1, JP14.1, R14.1, R15.2
CLAMP_HV: D1.C, IC3.9, IC4.9, R3.2
CLAMP_HV1: D2.C, IC7.9, IC8.9, R8.2
CLAMP_HV2: D3.C, IC11.9, IC12.9, R12.2
CLAMP_HV3: D4.C, IC15.9, IC16.9, R16.2
CLEAR: IC1.10, IC2.10, R1.1
CLEAR1: IC5.10, IC6.10, R7.1
CLEAR2: IC9.10, IC10.10, R11.1
CLEAR3: IC13.10, IC14.10, R15.1
CLK: IC1.11, IC2.11, JP1.2, JP3.2
CLK1: IC5.11, IC6.11, JP5.2, JP6.2
CLK2: IC9.11, IC10.11, JP9.2, JP10.2
CLK3: IC13.11, IC14.11, JP13.2, JP14.2
DATA_IN: IC1.14, JP1.4
DATA_IN1: IC5.14, JP5.4
DATA_IN2: IC9.14, JP9.4
DATA_IN3: IC13.14, JP13.4
DATA_OUT: IC2.9, JP3.4
DATA_OUT1: IC6.9, JP6.4
DATA_OUT2: IC10.9, JP10.4
DATA_OUT3: IC14.9, JP14.4
DIG0_HV: IC3.16, N1.8
DIG0_HV1: IC7.16, N2.8
DIG0_HV2: IC11.16, N3.8
DIG0_HV3: IC15.16, N4.8
DIG0_LV: IC1.15, IC3.1
DIG0_LV1: IC5.15, IC7.1
DIG0_LV2: IC9.15, IC11.1
DIG0_LV3: IC13.15, IC15.1
DIG1_HV: IC3.15, N1.14
DIG1_HV1: IC7.15, N2.14
DIG1_HV2: IC11.15, N3.14
DIG1_HV3: IC15.15, N4.14
DIG1_LV: IC1.1, IC3.2
DIG1_LV1: IC5.1, IC7.2
DIG1_LV2: IC9.1, IC11.2
DIG1_LV3: IC13.1, IC15.2
DIG2_HV: IC3.14, N1.9
DIG2_HV1: IC7.14, N2.9
DIG2_HV2: IC11.14, N3.9
DIG2_HV3: IC15.14, N4.9
DIG2_LV: IC1.2, IC3.3
DIG2_LV1: IC5.2, IC7.3
DIG2_LV2: IC9.2, IC11.3
DIG2_LV3: IC13.2, IC15.3
DIG3_HV: IC3.13, N1.11
DIG3_HV1: IC7.13, N2.11
DIG3_HV2: IC11.13, N3.11
DIG3_HV3: IC15.13, N4.11
DIG3_LV: IC1.3, IC3.4
DIG3_LV1: IC5.3, IC7.4
DIG3_LV2: IC9.3, IC11.4
DIG3_LV3: IC13.3, IC15.4
DIG4_HV: IC3.12, N1.1
DIG4_HV1: IC7.12, N2.1
DIG4_HV2: IC11.12, N3.1
DIG4_HV3: IC15.12, N4.1
DIG4_LV: IC1.4, IC3.5
DIG4_LV1: IC5.4, IC7.5
DIG4_LV2: IC9.4, IC11.5
DIG4_LV3: IC13.4, IC15.5
DIG5_HV: IC3.11, N1.12
DIG5_HV1: IC7.11, N2.12
DIG5_HV2: IC11.11, N3.12
DIG5_HV3: IC15.11, N4.12
DIG5_LV: IC1.5, IC3.6
DIG5_LV1: IC5.5, IC7.6
DIG5_LV2: IC9.5, IC11.6
DIG5_LV3: IC13.5, IC15.6
DIG6_HV: IC3.10, N1.2
DIG6_HV1: IC7.10, N2.2
DIG6_HV2: IC11.10, N3.2
DIG6_HV3: IC15.10, N4.2
DIG6_LV: IC1.6, IC3.7
DIG6_LV1: IC5.6, IC7.7
DIG6_LV2: IC9.6, IC11.7
DIG6_LV3: IC13.6, IC15.7
DIG7_HV: IC4.16, N1.6
DIG7_HV1: IC8.16, N2.6
DIG7_HV2: IC12.16, N3.6
DIG7_HV3: IC16.16, N4.6
DIG7_LV: IC1.7, IC4.1
DIG7_LV1: IC5.7, IC8.1
DIG7_LV2: IC9.7, IC12.1
DIG7_LV3: IC13.7, IC16.1
DIG8_HV: IC4.15, N1.3
DIG8_HV1: IC8.15, N2.3
DIG8_HV2: IC12.15, N3.3
DIG8_HV3: IC16.15, N4.3
DIG8_LV: IC2.15, IC4.2
DIG8_LV1: IC6.15, IC8.2
DIG8_LV2: IC10.15, IC12.2
DIG8_LV3: IC14.15, IC16.2
DIG9_HV: IC4.14, N1.5
DIG9_HV1: IC8.14, N2.5
DIG9_HV2: IC12.14, N3.5
DIG9_HV3: IC16.14, N4.5
DIG9_LV: IC2.1, IC4.3
DIG9_LV1: IC6.1, IC8.3
DIG9_LV2: IC10.1, IC12.3
DIG9_LV3: IC14.1, IC16.3
GND: C1.2, D1.A, IC1.8, IC2.8, IC3.8, IC4.8, JP2.1, JP4.1
GND1: C2.2, D2.A, IC5.8, IC6.8, IC7.8, IC8.8, JP7.1, JP8.1
GND2: C3.2, D3.A, IC9.8, IC10.8, IC11.8, IC12.8, JP11.1, JP12.1
GND3: C4.2, D4.A, IC13.8, IC14.8, IC15.8, IC16.8, JP15.1, JP16.1
HV_IN: JP2.2, JP4.2, R3.1, R4.2
HV_IN1: JP7.2, JP8.2, R5.2, R8.1
HV_IN2: JP11.2, JP12.2, R9.2, R12.1
HV_IN3: JP15.2, JP16.2, R13.2, R16.1
LATCH: IC1.12, IC2.12, JP1.3, JP3.3
LATCH1: IC5.12, IC6.12, JP5.3, JP6.3
LATCH2: IC9.12, IC10.12, JP9.3, JP10.3
LATCH3: IC13.12, IC14.12, JP13.3, JP14.3
unnamed: IC1.9, IC2.14
unnamed: N2.4, R5.1
unnamed: IC5.9, IC6.14
unnamed: N1.4, R4.1
unnamed: N3.4, R9.1
unnamed: IC9.9, IC10.14
unnamed: N4.4, R13.1
unnamed: IC13.9, IC14.14
OE: IC1.13, IC2.13, JP1.5, JP3.5, R2.2
OE1: IC5.13, IC6.13, JP5.5, JP6.5, R6.2
OE2: IC9.13, IC10.13, JP9.5, JP10.5, R10.2
OE3: IC13.13, IC14.13, JP13.5, JP14.5, R14.2
