putyn/nixie-clock/(commit log)

2017-02-05 slow progress
    added new version for in4 PCB + some cleaning of files
    [boosst_new.sch, boosst_revA.brd, boosst_revA.sch, boosst_revB.brd, boosst_revB.sch, display_in4.brd, display_in4.sch, in4_mount.brd]
2017-03-06 control board, new dc-dc module, renaming
    [1363_Radj.xlsx, in4_control_v1.0_revA.brd, in4_control_v1.0_revA.sch, in4_single_v0.2_revA.brd, in4_single_v0.2_revA.sch, in4_single_v0.2_revB.brd, in4_single_v0.2_revB.sch]
2017-03-21 first try at a case, HVPS voltage calc
    [1363_Radj.xlsx]
2017-03-27 case model
2017-06-11 brightness, ACP, fixes #2
    [hwspecific.ino, naked_nixie.ino]
2017-06-18 acp rework, updated webui
    [hwspecific.ino, naked_nixie.ino]
2017-07-21 device changes, acp rework
    [hwspecific.ino, naked_nixie.ino]
2017-08-01 cleanup, schematic, footprint change
    [in4_single_v0.2_revB.brd, in4_single_v0.2_revB.sch]
2019-04-27 Naked Nixie control board schematic
